KaveeshaAlwis/PostureSence/Screenshots/telegram_bot_notification.jpeg

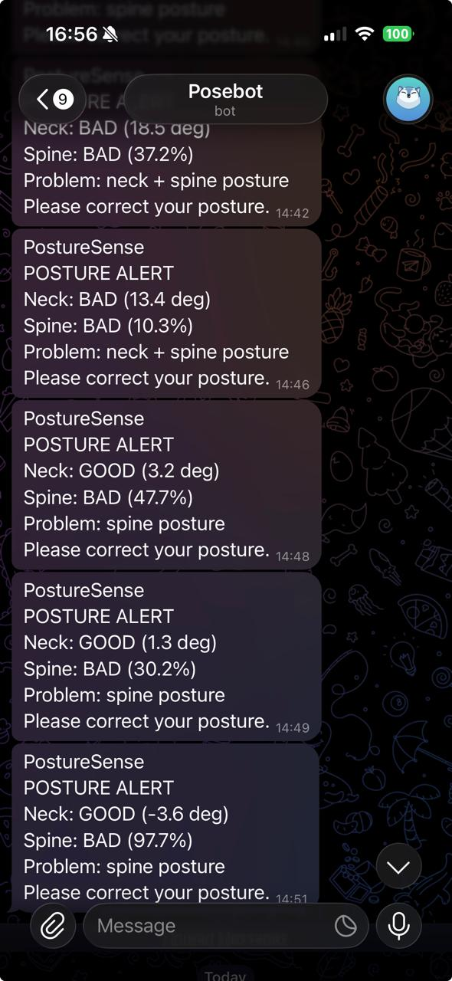
Screenshots/telegram_bot_notification.jpeg
