KaveeshaAlwis/PostureSence/Screenshots/dashboad view 03.png

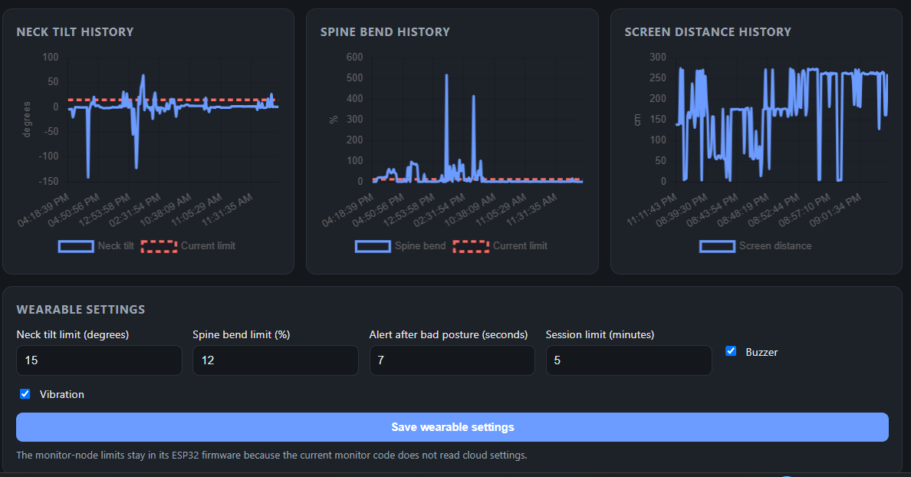
Screenshots/dashboad view 03.png
