KaveeshaAlwis/PostureSence/Screenshots/dashboard view01.png

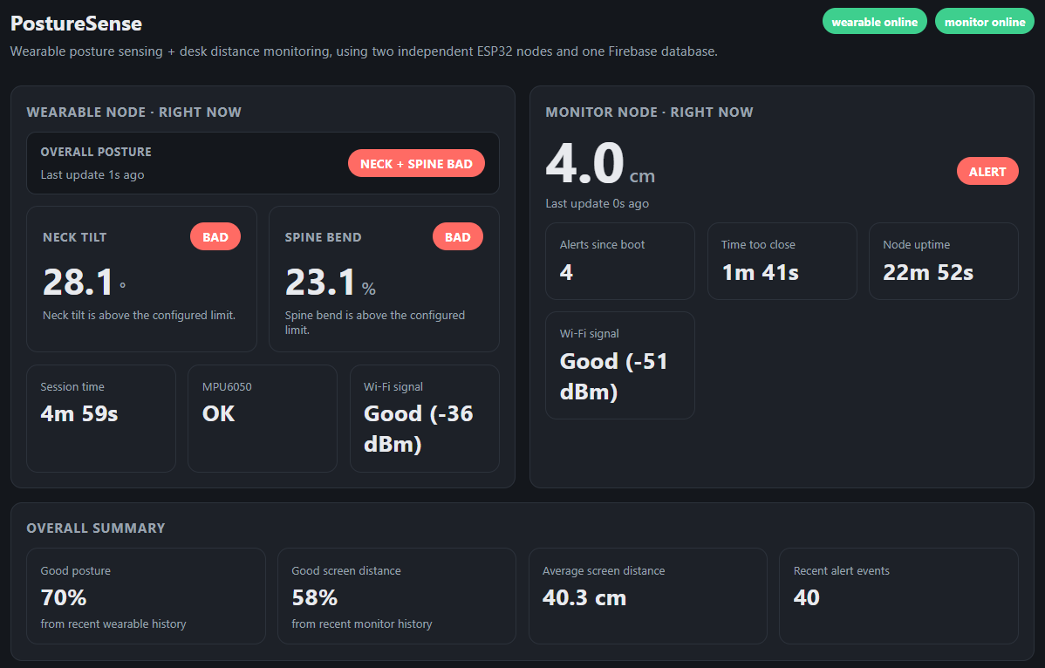
Screenshots/dashboard view01.png
