KaveeshaAlwis/PostureSence/Screenshots/dashboard view02.png

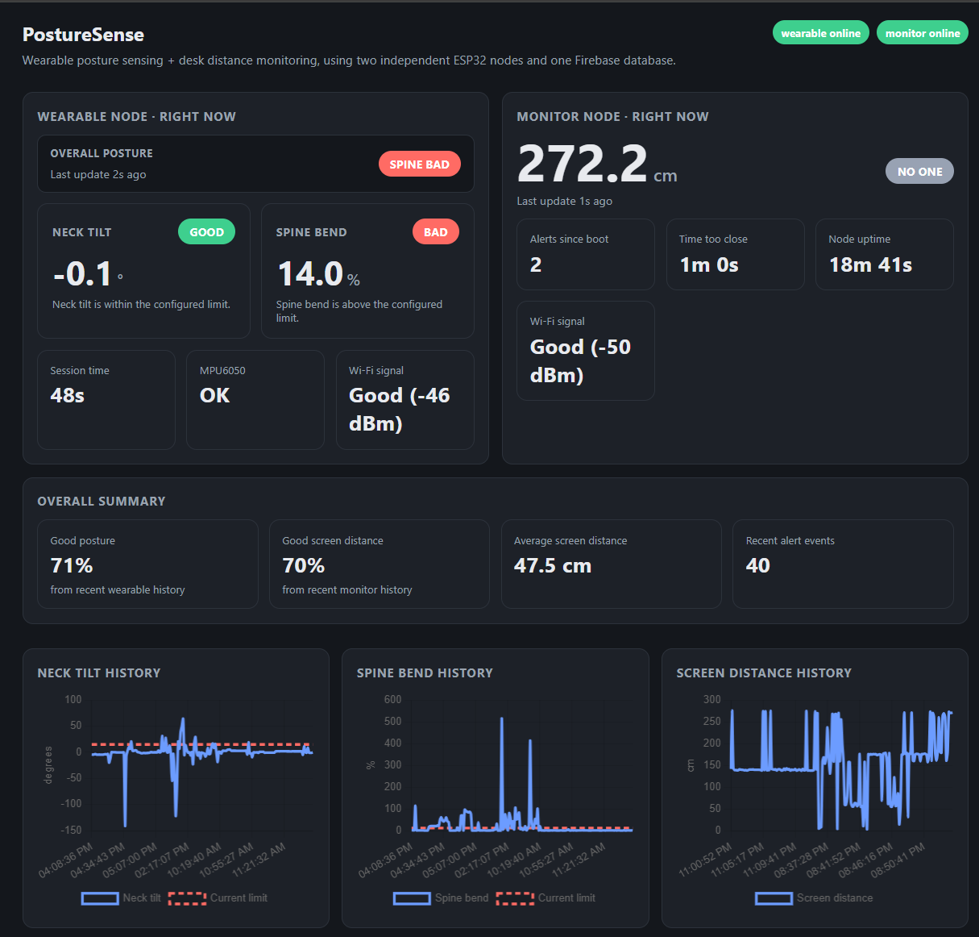
Screenshots/dashboard view02.png
