KaveeshaAlwis/PostureSence/Screenshots/Screenshot 2026-10-13 211534.png

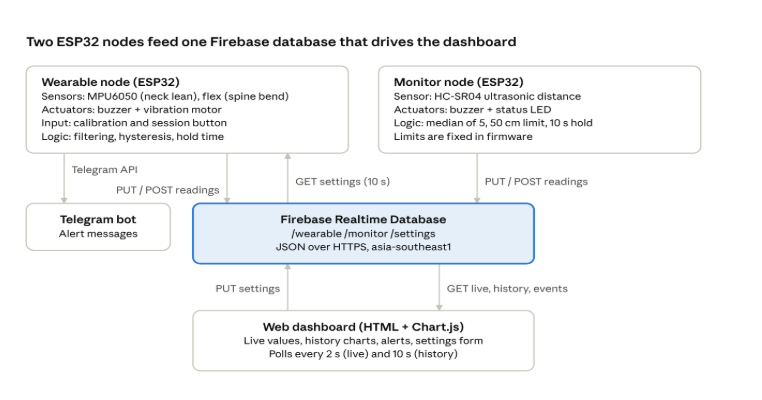
Screenshots/Screenshot 2026-10-13 211534.png
