KaveeshaAlwis/PostureSence/Screenshots/Screenshot 2026-10-13 220520.png

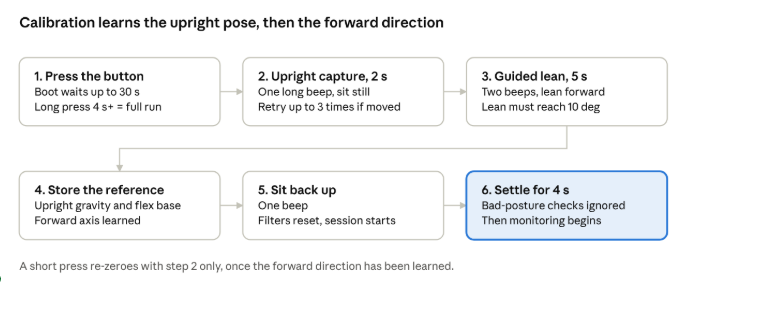
Screenshots/Screenshot 2026-10-13 220520.png
