KaveeshaAlwis/PostureSence/Screenshots/Screenshot 2026-10-13 220610.png

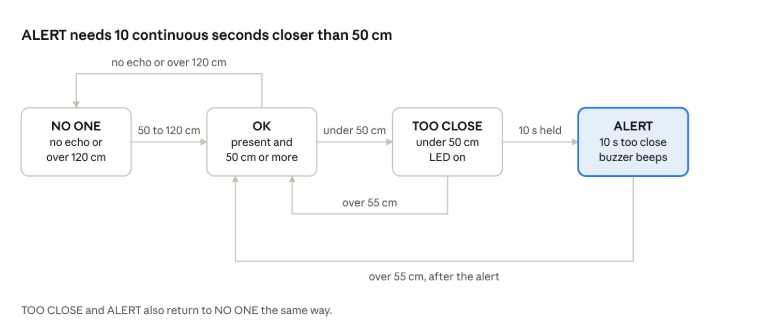
Screenshots/Screenshot 2026-10-13 220610.png
