KaveeshaAlwis/PostureSence/Screenshots/Screenshot 2026-10-13 220619.png

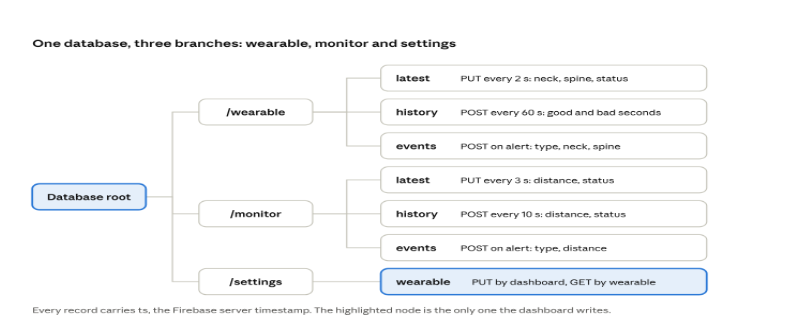
Screenshots/Screenshot 2026-10-13 220619.png
