KaveeshaAlwis/PostureSence/Screenshots/node_a_wearable_wiring_usb.png

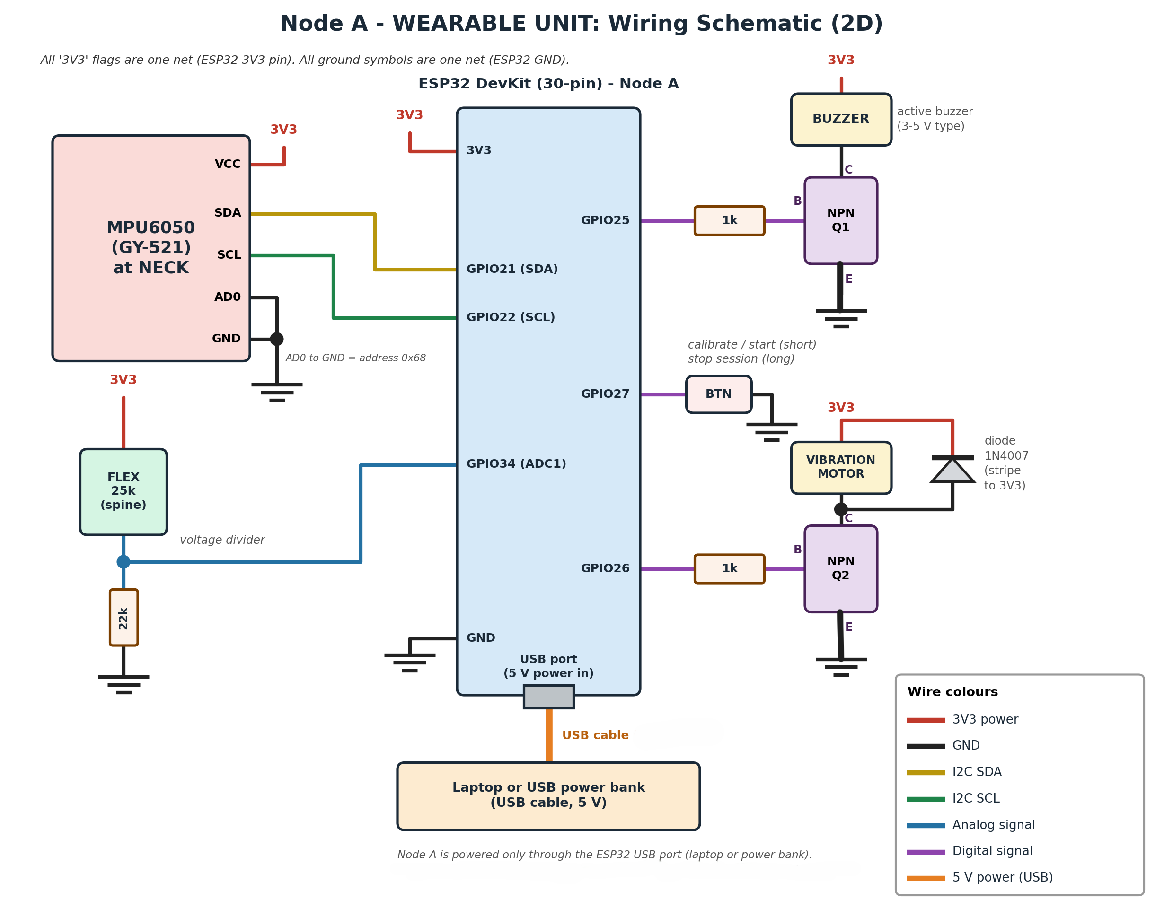
Screenshots/node_a_wearable_wiring_usb.png
