KaveeshaAlwis/PostureSence/Screenshots/wiring_2d_monitor.png

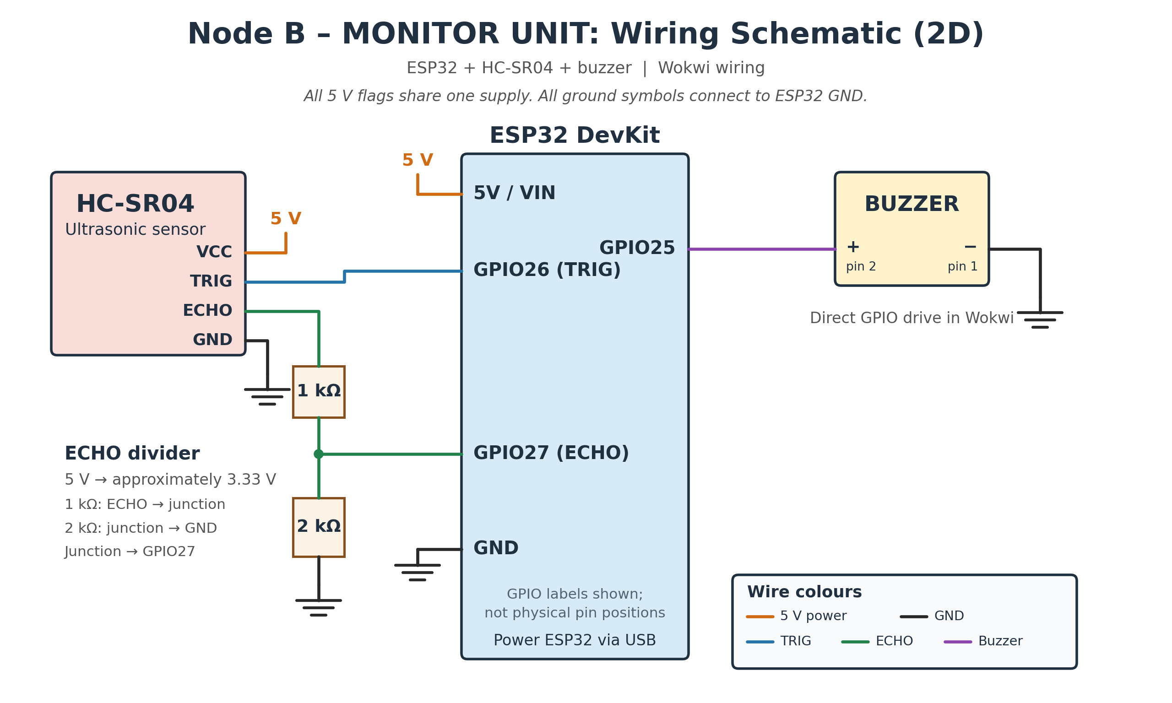
Screenshots/wiring_2d_monitor.png
