KaveeshaAlwis/PostureSence/Screenshots/neck sensor test01.jpeg

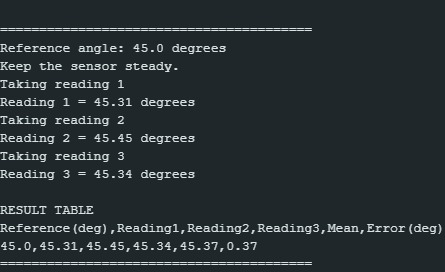
Screenshots/neck sensor test01.jpeg
