KaveeshaAlwis/PostureSence/Screenshots/neck sensor test03.jpeg

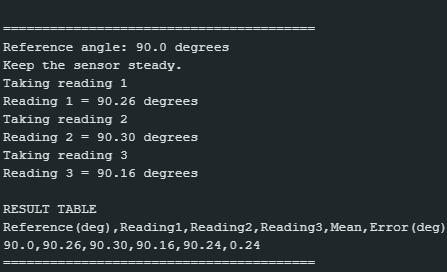
Screenshots/neck sensor test03.jpeg
